bvernoux/kicad_rf/README.md

# kicad_rf
KiCad RF experimentations with some RF boards including Qucs Projects and Measurements with VNA HP8753D(30KHz-6GHz)
