bvernoux/kicad_rf/6Layers_trl-board_microstrip_v0_1_OSHPark/README.md

6Layers_trl-board_microstrip_v0_1
==============================

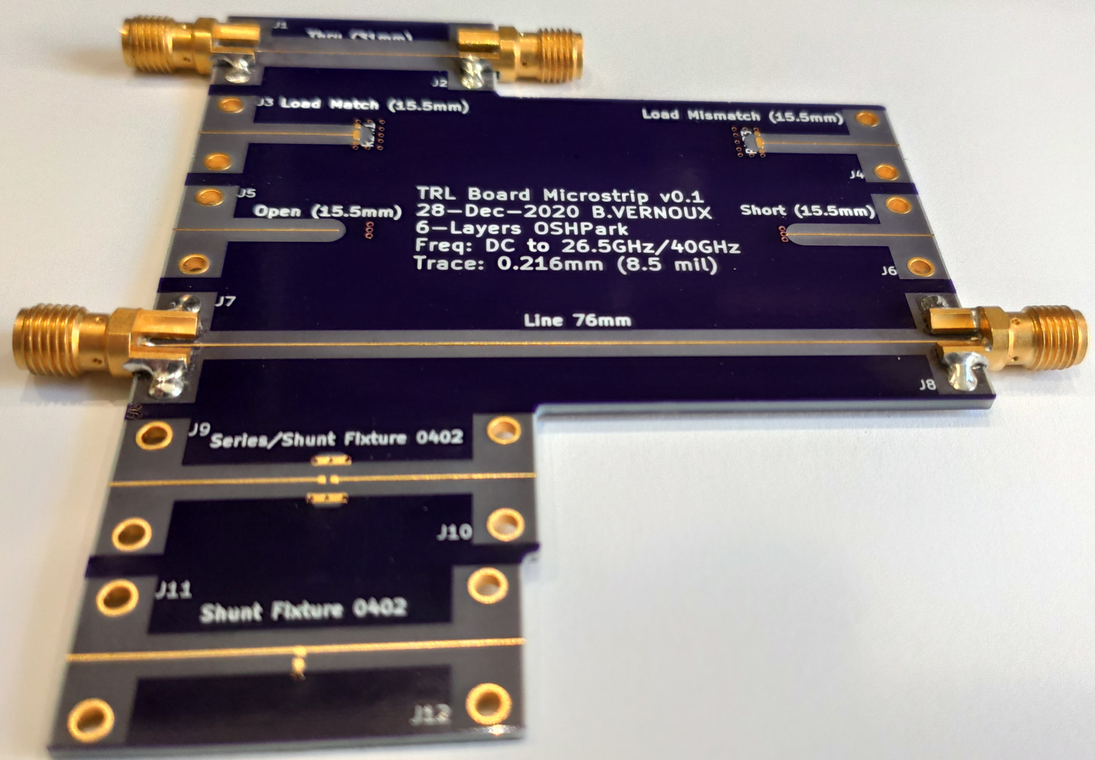
[picture p1: 6Layers_trl-board_microstrip_v0_1_OSHPark/6Layers_trl-board_microstrip_v0_1_OSHPark.jpg]
6Layers trl-board microstrip v0.1 OSHPark


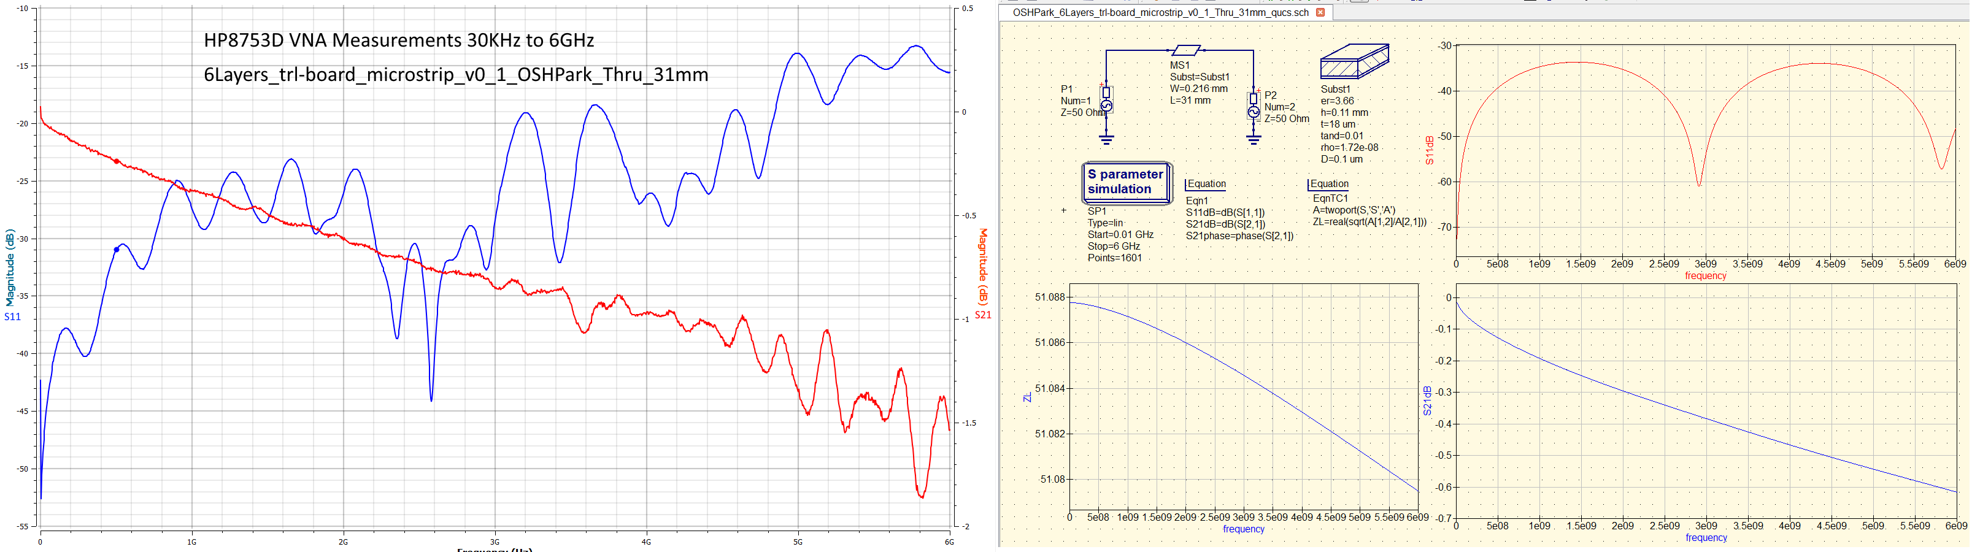
[picture p2: 6Layers_trl-board_microstrip_v0_1_OSHPark/6Layers_trl-board_microstrip_v0_1_OSHPark_Thru_31mm_Measurements_Simu.png]
6Layers trl-board microstrip v0.1 OSHPark Thru 31mm Measurements vs Simulation


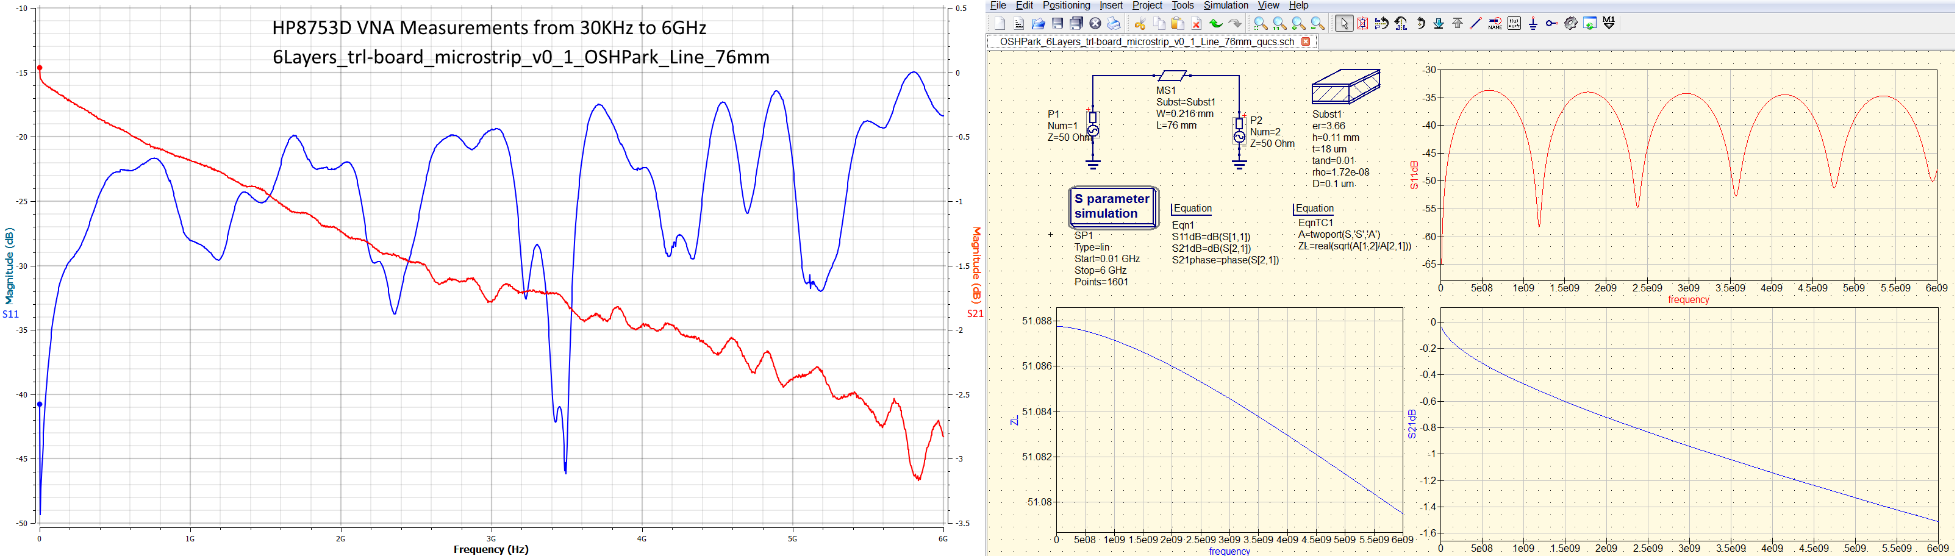
[picture p3: 6Layers_trl-board_microstrip_v0_1_OSHPark/6Layers_trl-board_microstrip_v0_1_OSHPark_Line_76mm_Measurements_Simu.png]
6Layers trl-board microstrip v0.1 OSHPark Line 76mm Measurements vs Simulation


This board is based on Mario Hellmich's design see https://www.mariohellmich.de/projects/trl-cal/trl-cal.html

TRL Calibration Board for evaluation of Southwest Microwave 1092-02A-5(up to 40 GHz) or BELFUSE / Cinch 142-0771-831(Up to 26.5GHz) or cheap SMA connectors.
50 Ohms Impedanced Matched with OSHPark 6Layers FR408-HR

It contains following features:
* A thru standard for TRL
* A 50 Ohms match standard
* A 25 Ohms mismatch standard for verification
* An open standard for verification
* A short standard, used as a reflect standard for TRL
* A line of 45 mm length (Called also "Line 76mm" to reflect total length), used as a line standard for TRL
* A series fixture for 0402 components
* A shunt fixture for 0402 components

The board is designed assuming the following parameters (based on [OSH Park 6 Layers 190Tg FR408-HR specifications](https://docs.oshpark.com/services/six-layer)):
* Base Material / Board thickness: 1.6 mm (63 mil)
* Conductor Height: 0.1107 mm (4.36 mil) FR408-HR
* Trace: 0.216mm (8.5mil)
* Permittivity: FR408-HR 106 75% prepreg about 3.66 (3.23@1GHz)
* Loss Tangent: 0.011
* Copper Weight: 1oz outer (35µm), 1/2oz inner (17.5µm)
* Trace surface: 1 oz copper clad+plated
* Impedance: 50 Ohms (+/-10% => +/-5 Ohms)
* PCB Finish: ENIG (Gold)

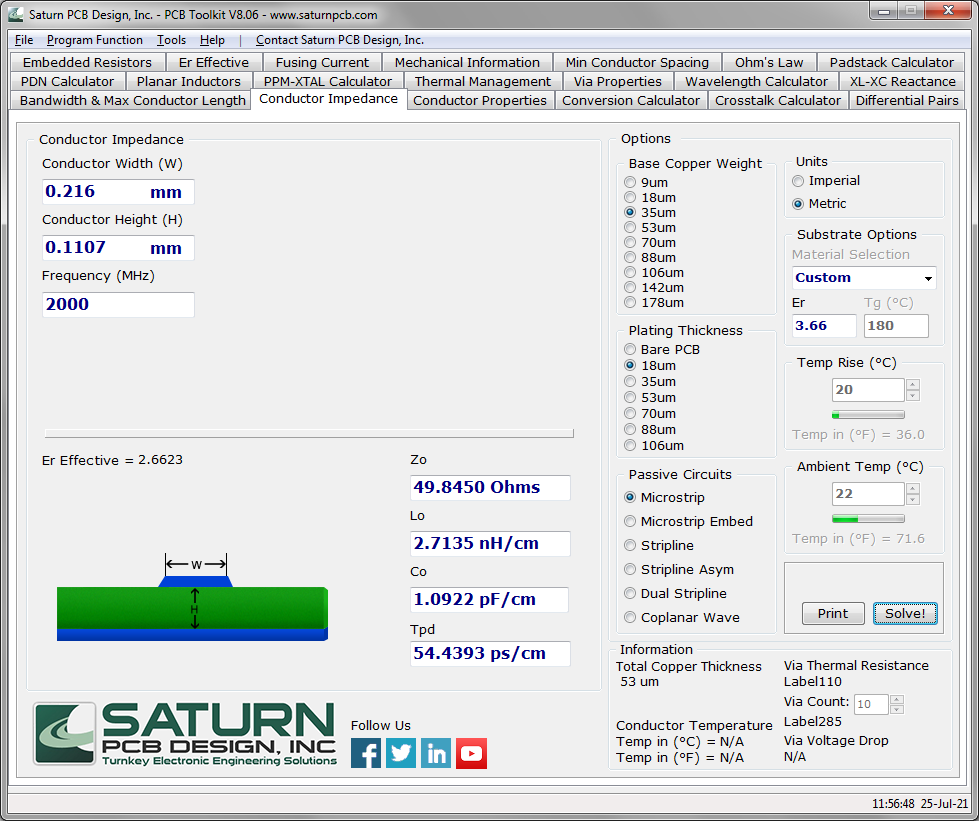
[picture p4: 6Layers_trl-board_microstrip_v0_1_OSHPark/SaturnPCB_PCB_Toolkit_v8_06_Microstrip_Z50Ohms_OSHPark_6Layers.png]
SaturnPCB_PCB_Toolkit_v8_06_Microstrip_Z50Ohms_OSHPark_6Layers


For more details on TRL see https://www.mariohellmich.de/projects/trl-cal/trl-cal.html
