bvernoux/kicad_rf/4Layers_trl-board_v0_3/README.md

4Layers_trl-board_v0_3
==============================

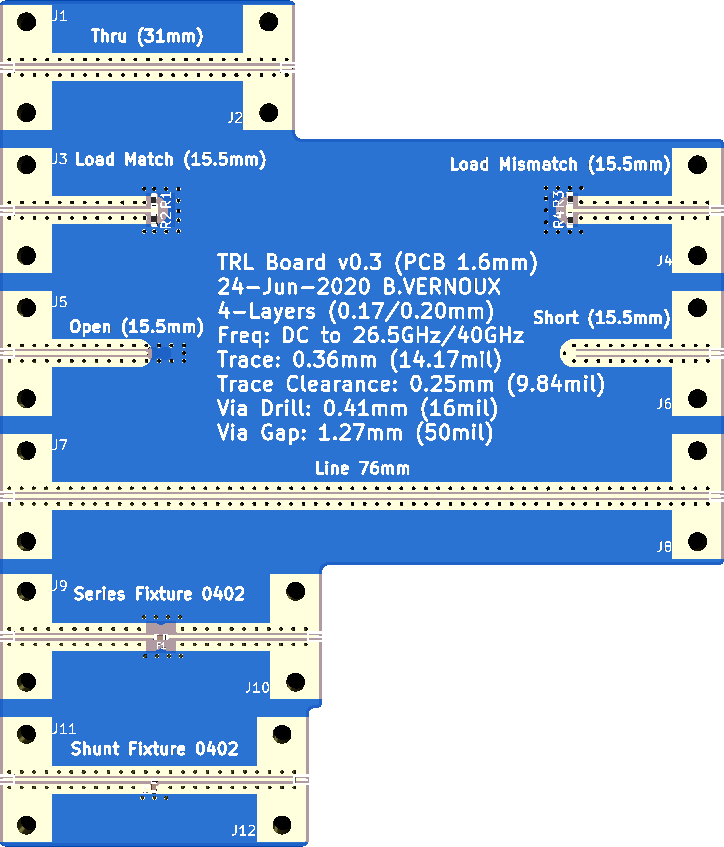
[picture p5: 4Layers_trl-board_v0_3/4Layers_trl-board_v0_3_Top.png]
4Layers trl-board v0.3

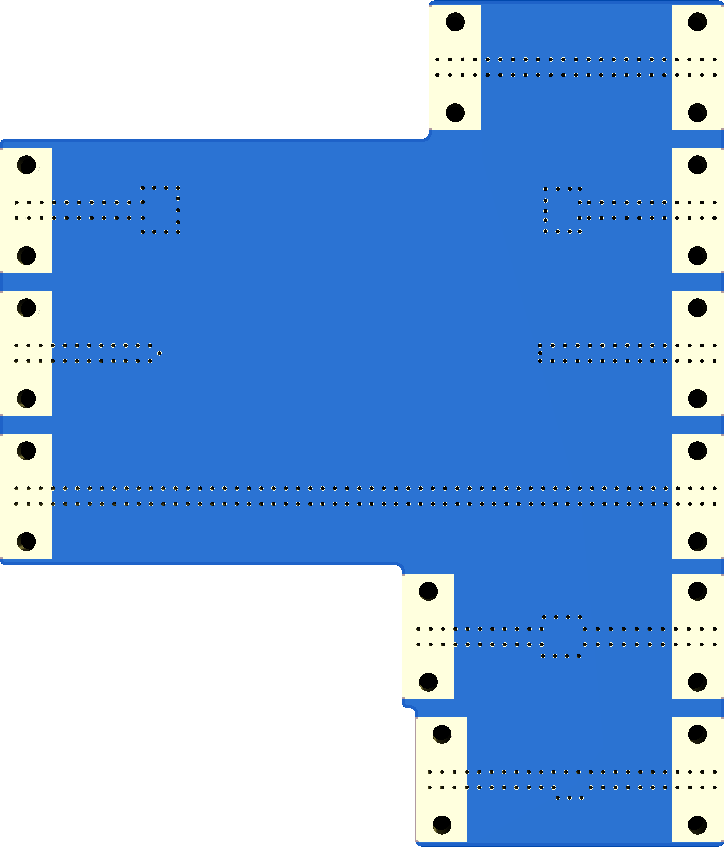
[picture p6: 4Layers_trl-board_v0_3/4Layers_trl-board_v0_3_Bottom.png]
4Layers trl-board v0.3


This board is based on Mario Hellmich's design see https://www.mariohellmich.de/projects/trl-cal/trl-cal.html

TRL Calibration Board for evaluation of Southwest Microwave 1092-02A-5(up to 40 GHz) or BELFUSE / Cinch 142-0771-831(Up to 26.5GHz) or cheap SMA connectors.
50 Ohms Impedanced Matched with OSHPark 4Layers FR408-HR or JLCPCB 4Layers JLC7628

It contains following features:
* A thru standard for TRL
* A 50 Ohms match standard
* A 25 Ohms mismatch standard for verification
* An open standard for verification
* A short standard, used as a reflect standard for TRL
* A line of 45 mm length (Called also "Line 76mm" to reflect total length), used as a line standard for TRL
* A series fixture for 0402 components
* A shunt fixture for 0402 components

The board is designed assuming the following parameters (based on [OSH Park 4 Layers 190Tg FR408-HR specifications](https://docs.oshpark.com/services/four-layer)):
* Base Material / Board thickness: 1.6 mm (63 mil)
* Conductor Height 0.20mm (or 0.17mm FR408-HR)
* Center Conductor Width: 0.36 mm (14.17 mil)
* Gap Width: 0.25 mm (9.84 mil)
* Permittivity: FR408-HR 3.66 (3.68 @2GHz) or FR4 4.6
* Loss Tangent: 0.0092 @2GHz
* Copper Weight: 1oz outer (35µm), 1/2oz inner (17.5µm)
* Trace surface: Cu
* Impedance: 50 Ohms (+/-2 Ohms)
* PCB Finish: ENIG (Gold)

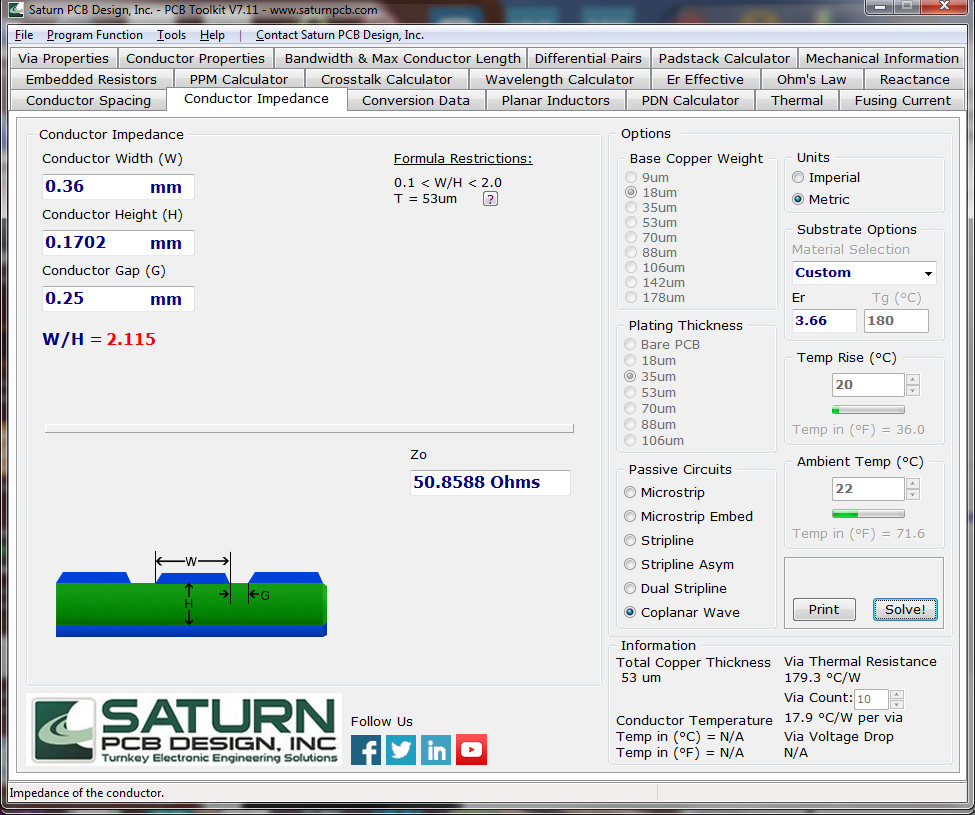
[picture p7: 4Layers_trl-board_v0_3/SaturnPCB_PCB_Toolkit_v7_11_CPWG_Z50Ohms_OSHPark_4Layers.jpg]
SaturnPCB_PCB_Toolkit_v7_11_CPWG_Z50Ohms_OSHPark_4Layers

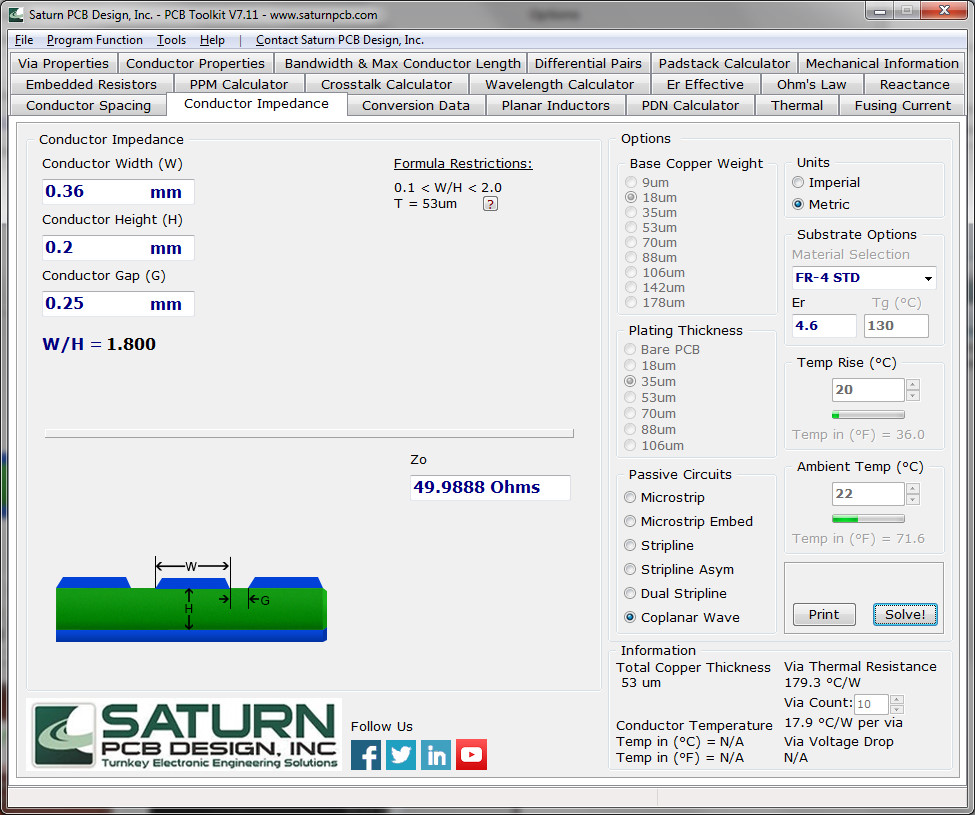
[picture p8: 4Layers_trl-board_v0_3/SaturnPCB_PCB_Toolkit_v7_11_CPWG_Z50Ohms_JLC7628_4Layers.jpg]
SaturnPCB_PCB_Toolkit_v7_11_CPWG_Z50Ohms_JLC7628_4Layers


For more details on TRL see https://www.mariohellmich.de/projects/trl-cal/trl-cal.html
