bvernoux/kicad_rf/4Layers_trl-board_v0_3/4Layers_trl-board.kicad_pcb

## KiCad design 4Layers_trl-board_v0_3/4Layers_trl-board.kicad_pcb (2021-08-17)

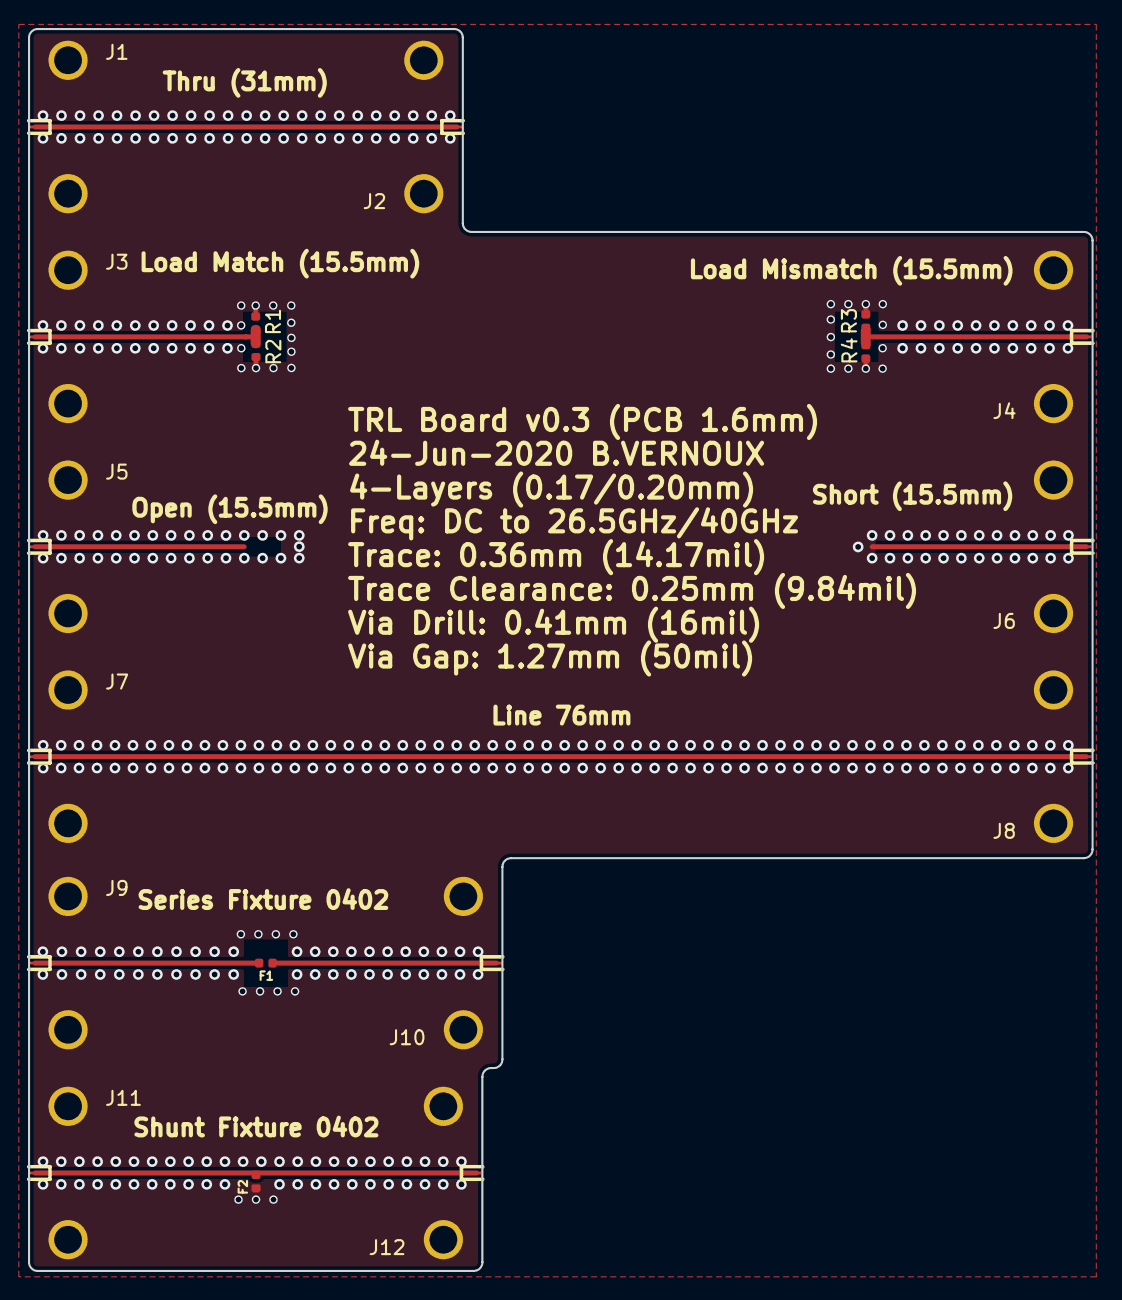
[picture p11: board 4Layers_trl-board.kicad_pcb from above]

Board: 4 copper layers, 76.0 x 88.8 mm, 18 parts (0 on the bottom side), 8 nets.

Parts:
F1, F2: Fixture 0402; C_0402_1005Metric
J1, J2, J3, J4, J5, J6, J7, J8, J9, J10, J11, J12: 142-0771-831; Southwest_Microwave_1092-02A-5
R1, R2: 100; R_0402_1005Metric
R3, R4: 50; R_0402_1005Metric

Connections:
GND: F2.1, J1.2, J2.2, J3.2, J4.2, J5.2, J6.1, J6.2, J7.2, J8.2, J9.2, J10.2, J11.2, J12.2, R1.2, R2.2, R3.2, R4.2
unnamed: F1.1, J10.1
unnamed: F1.2, J9.1
unnamed: F2.2, J11.1, J12.1
unnamed: J1.1, J2.1
unnamed: J3.1, R1.1, R2.1
unnamed: J4.1, R3.1, R4.1
unnamed: J7.1, J8.1
