bvernoux/kicad_rf/sma-probetarget_oshpark_bve_v0_4/sma-probetarget.kicad_pcb

## KiCad design sma-probetarget_oshpark_bve_v0_4/sma-probetarget.kicad_pcb (2020-05-07)

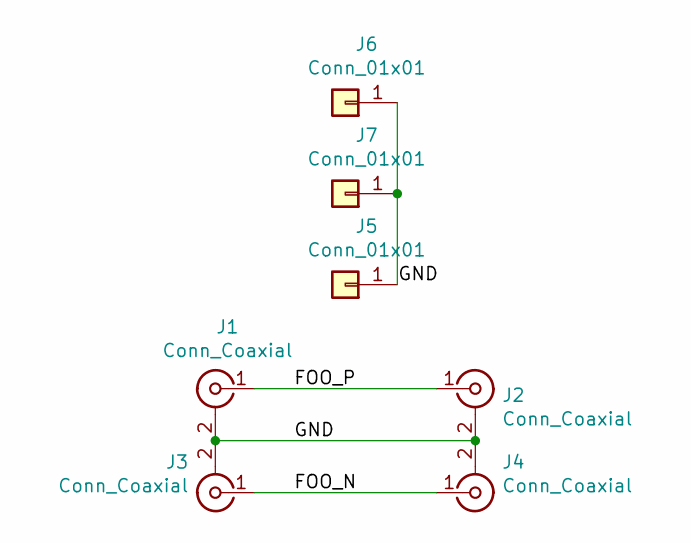
[picture p12: schematic sma-probetarget.sch]

Parts:
J1, J2, J3, J4: Conn_Coaxial; SMA-Launcher_Cinch_142-0771-831
J5: Conn_01x01; TESTPOINT_SMT_KEYSTONE_5016
J6, J7: Conn_01x01; TESTPOINT_BARETRACE_328UM

Connections:
/FOO_N: J3.1 (In), J4.1 (In)
/FOO_P: J1.1 (In), J2.1 (In)
/GND: J1.2 (Ext), J2.2 (Ext), J3.2 (Ext), J4.2 (Ext), J5.1, J6.1, J7.1

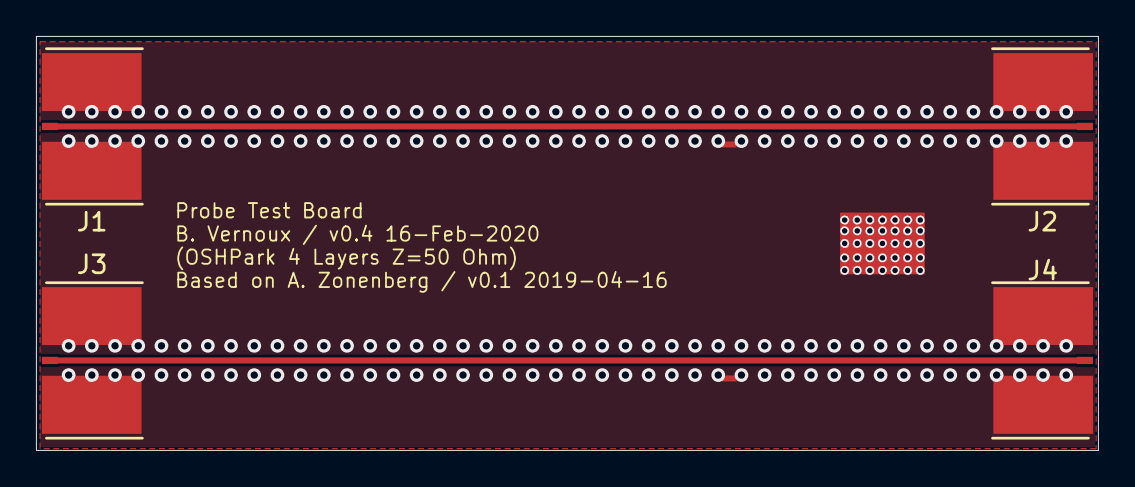
[picture p13: board sma-probetarget.kicad_pcb from above]

Board: 4 copper layers, 59.0 x 23.0 mm, 7 parts (0 on the bottom side), 3 nets.
