bvernoux/kicad_rf/(commit log)

2020-02-17 Import OSHPark_4Layers_trl-board_v0_1
    [OSHPark_4Layers_trl-board_v0_1-B_Mask.GBS, OSHPark_4Layers_trl-board_v0_1-B_Paste.GBP, OSHPark_4Layers_trl-board_v0_1-B_SilkS.GBO, OSHPark_4Layers_trl-board_v0_1-Bottom.GBL, OSHPark_4Layers_trl-board_v0_1-Edge_Cuts.GKO, OSHPark_4Layers_trl-board_v0_1-F_Mask.GTS, OSHPark_4Layers_trl-board_v0_1-F_Paste.GTP, OSHPark_4Layers_trl-board_v0_1-F_SilkS.GTO]
2020-05-07 sma-probetarget_oshpark_bve_v0_4 first import
    [sma-probetarget.kicad_pcb, sma-probetarget.sch]
2020-06-24 4Layers trl-board v0.3
    [4Layers_trl-board.kicad_pcb, 4Layers_trl-board.sch]
2021-06-12 Footprint for SMA Edge connector (up to 40GHz) to "rule them all" Southwest Microwave 1092-02A-5 Amphenol RF 901_10510-2 & 901-10511-3 Compatible with Belfuse 142-0771-831 and Mueller Electric Co BU-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
2021-06-12 Changed holes size from 0.95mm to 1.1mm (recommendations confirmed by Technical support of Amphenol RF) for the 4 "legs" for part 901-10510-2
2021-07-25 First import 6 Layers trl-board microstrip v0.1 OSHPark
    [6Layers_trl-board-B_Cu.GBL, 6Layers_trl-board-B_Cu.gbl, 6Layers_trl-board-B_Mask.GBS, 6Layers_trl-board-B_Mask.gbs, 6Layers_trl-board-B_Paste.GBP, 6Layers_trl-board-B_Paste.gbp, 6Layers_trl-board-B_SilkS.GBO, 6Layers_trl-board-B_SilkS.gbo]
2021-07-25 Changed holes size from 1.1mm to 1.0mm (as 1.1mm is a bit loose) for the 4 "legs" for part 901-10510-2
2021-08-17 Updated footprint for easier soldering
2021-08-17 Added footprint for basic components R/L/C/DIODE/LED
    [4Layers_trl-board.kicad_pcb]
